tedyapo/ten-year-flashlight/PCB/tritiled_nocell_rprogrammable.brd

## EAGLE design PCB/tritiled_nocell_rprogrammable.brd (2020-07-19)

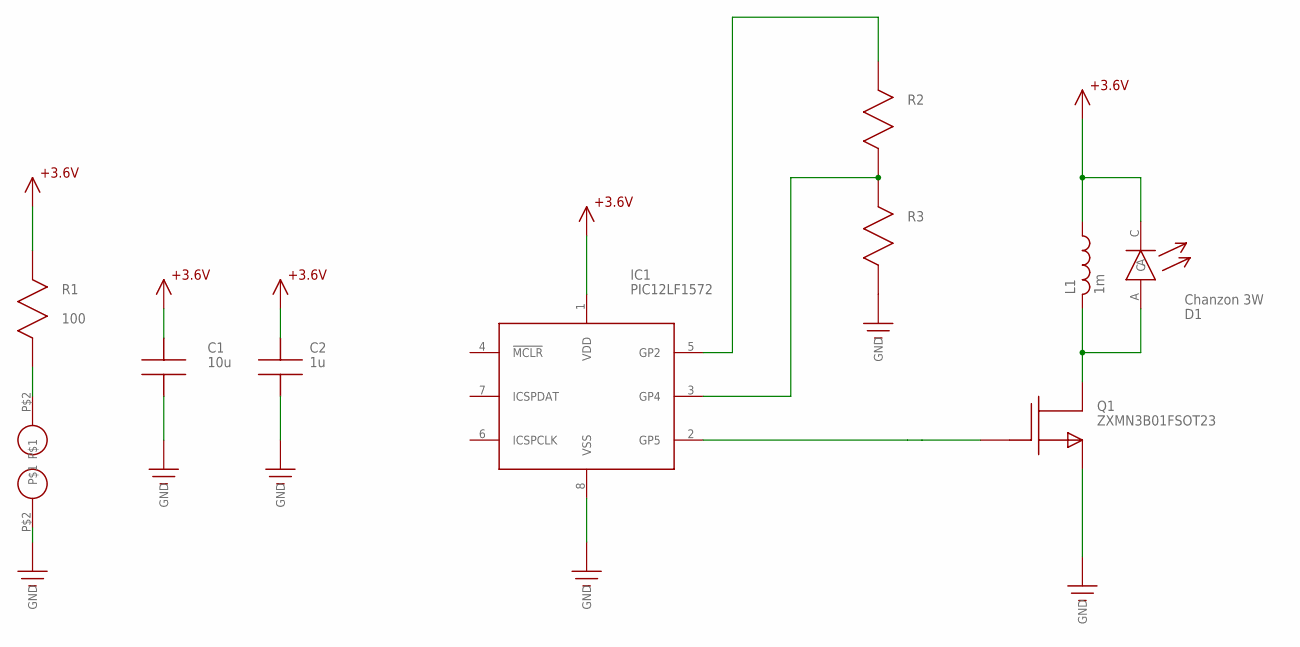
[picture p1: schematic tritiled_nocell_rprogrammable.sch]

Parts:
C1: 10u; 1206
C2: 1u; C0603
D1: Chanzon 3W; LED_3W
IC1: PIC12LF1572; SOIC8
L1: 1m; SRR6028_INDUCTOR
Q1: ZXMN3B01FSOT23; SOT-23
R1: 100; R1206
R2, R3: R1206
U$7, U$9: ICSP_PAD

Connections:
+3.6V: C1.P$1, C2.P$1, D1.C, IC1.1 (VDD), L1.P$1 (1), R1.P$1
GND: C1.P$2, C2.P$2, IC1.8 (VSS), Q1.2 (S), R3.P$2, U$9.P$2
unnamed: IC1.3 (GP4), R2.P$2, R3.P$1
unnamed: R1.P$2, U$7.P$2
unnamed: IC1.5 (GP2), R2.P$1
unnamed: D1.A, L1.P$2 (2), Q1.3 (D)
unnamed: IC1.2 (GP5), Q1.1 (G)

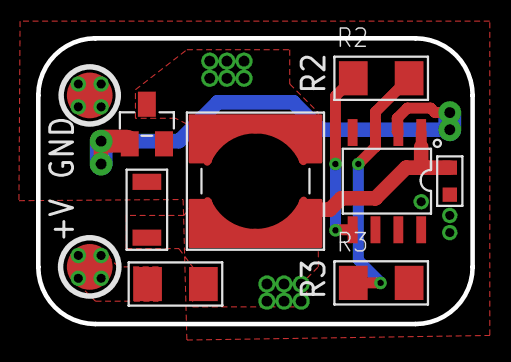
[picture p2: board tritiled_nocell_rprogrammable.brd from above]

Board: 2 copper layers, 24.1 x 15.9 mm, 11 parts (1 on the bottom side), 7 nets.
