tedyapo/ten-year-flashlight/PCB/tritiled_nocell.brd

## EAGLE design PCB/tritiled_nocell.brd (2016-12-26)

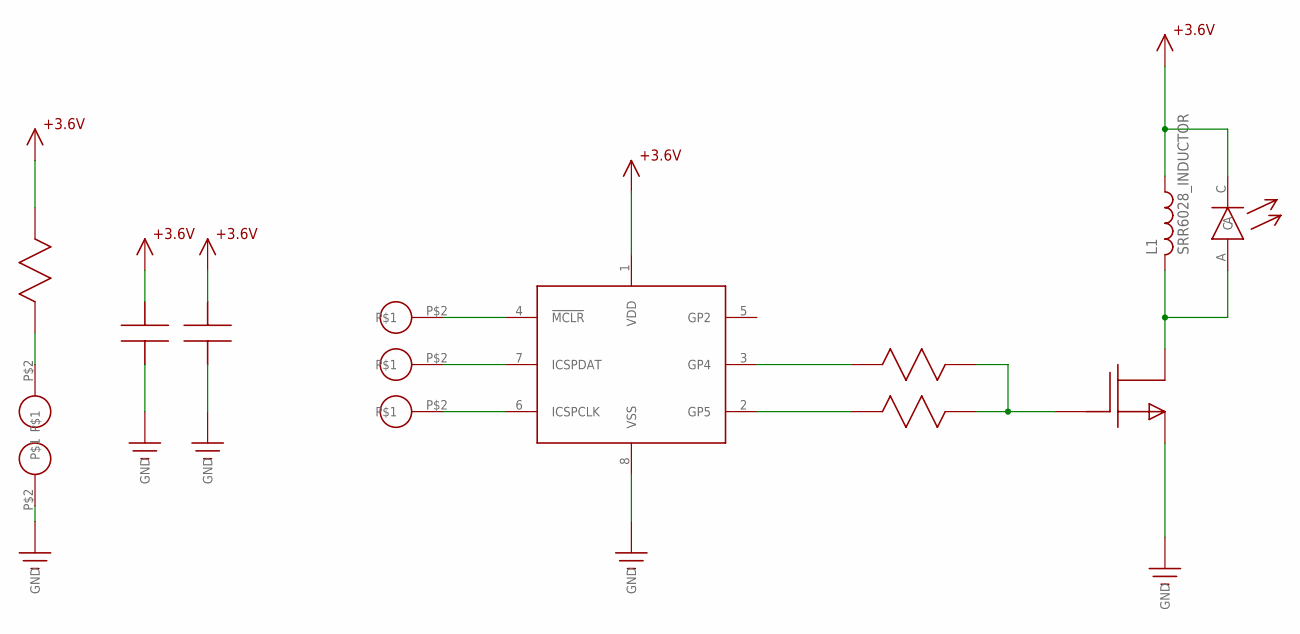
[picture p3: schematic tritiled_nocell.sch]

Parts:
L1: SRR6028_INDUCTOR
U$1: PIC12LF1571; SOIC8
U$7, U$9, U$17, U$18, U$19: ICSP_PAD
U$10: R1206
U$12: LED_3W
U$16: ZXMN3B01FSOT23; SOT-23
U$20: C1206; 1206
U$21: C0603
U$22, U$23: R0603

Connections:
+3.3V: L1.P$1 (1), U$1.1 (VDD), U$10.P$1, U$12.C, U$20.P$1, U$21.P$1
GND: U$1.8 (VSS), U$9.P$2, U$16.2 (S), U$20.P$2, U$21.P$2
unnamed: U$1.4 (!MCLR!), U$18.P$2
unnamed: U$7.P$2, U$10.P$2
unnamed: U$1.7 (ICSPDAT), U$19.P$2
unnamed: U$1.6 (ICSPCLK), U$17.P$2
unnamed: L1.P$2 (2), U$12.A, U$16.3 (D)
unnamed: U$1.3 (GP4), U$23.P$1
unnamed: U$1.2 (GP5), U$22.P$1
unnamed: U$16.1 (G), U$22.P$2, U$23.P$2

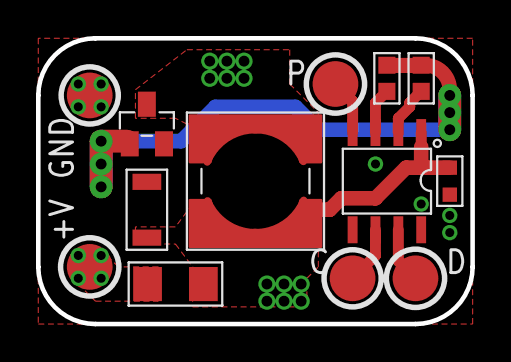
[picture p4: board tritiled_nocell.brd from above]

Board: 2 copper layers, 24.1 x 15.9 mm, 14 parts (1 on the bottom side), 10 nets.
