tedyapo/ten-year-flashlight/(threads)

Thread 3 (2022-03-28):

Not an issue - It's still working flawlessly.

Sarah-C, 2022-03-28:
Several years on, and my flashlight's still going strong.

It's my main night-time house trip flashlight. I stand it on end on the bedside table to light the room enough to see what my cat's doing, and grab a drink.

It works great for bathroom visits too - any stray household objects show up in the 20 degree beam easily in the depth of night.

Being green for the eye's sensitivity works for shut eyes too - eyelids filter all the light out, so flashing it around a room at night doesn't wake anyone up.

Knowing it's always there and on, if there's a power cut or otherwise is quite a reassuring thing. =)

tedyapo, 2022-03-29:
send me your address again and i'll send you a translucent washer. an undocumented upgrade that helps find it at night.

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

Sarah-C, 2022-04-04:
Did you get my email?

It may have gone into spam. =(

Closed 2022-03-29.
